andrea-pacelli/pimpabox/docs/pimpabox_pcb.pdf

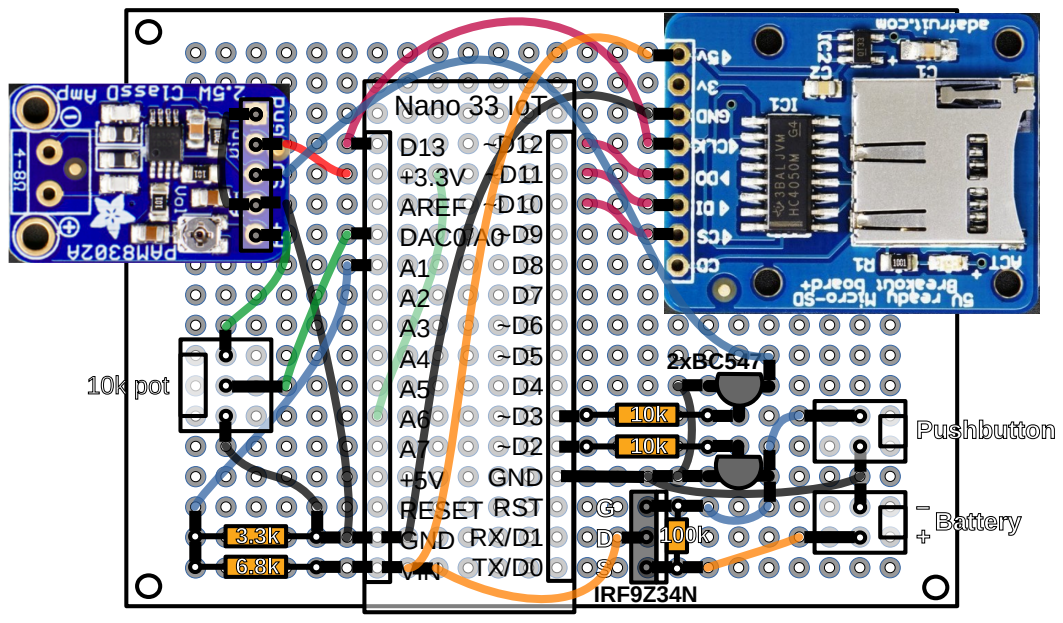
[picture p1: page 1]
Nano 33 IoT; D13 +3.3V AREF DAC0/A0 A1 A2 A3 A4 A5 A6 A7 +5V RESET GND VIN; ~D12 ~D11 ~D10 ~D9 D8 D7 ~D6 ~D5 D4 ~D3 ~D2 GND RST RX/D1; GDS; IRF9Z34N; Pushbutton; Battery; 2xBC547; 10k pot
