andrea-pacelli/pimpabox/(commit log)

2024-11-21 Named SD_CS and battery pins; added low battery check, sad trombone sound.
2024-11-21 Added pin_power and low-battery shutdown.
2024-11-21 First draft of PCB layout (not complete).
2024-11-23 Added pin_shutdown to suppress popping sound on power-on; factored out amp power on/off and AudioZero.play() to playFile(). Completed PCB layout.
2024-11-24 Changed PCB layout to fix some design flaws (switched PAM8302 to 3.3V supply because it cannot take 6V; added volume control since music once started is unstoppable).
2024-11-25 Added random seed based on battery voltage.
2024-11-28 Changed SD CS pin to 4 per PCB design.
2024-11-29 Added IMU (diagnostic only)
2024-11-29 Added power down after playing song
2024-12-01 Refactoring of playFile()
    Changed playFile() input argument to char *filename to make it a full
    service function, including file open/close/error handling, serial
    diagnostics, and 0.5s delay after playing.
    [pimpabox.ino]
2024-12-14 Replaced IMU-based song selection with EEPROM-based song rotation.
    [pimpabox.ino]
2024-12-20 Added ability to play any number of songs
    Added vector<string> file_names and associated functions
    readFileNames() and printFileNames().
